swargo98/Gesture-Based-Elevator-Control-System/README.md

# Gesture Based Elevator Control System
 
For our CSE316 term project, we have built a system where we can use an elevator to go to a certain floor of a building, only by our hand gestures. This will help us a lot in avoiding touching buttons in this COVID-ridded world. We used ATMEGA micro controllers and LDR-LED couples, which is very cost effective and can be easily implement the system even in the suburban cities.

Team:
- 1705039 - Tahmeed Tarek
- 1705051 - Rasman Mubtasim Swargo
- 1705053 - Tousif Tanjim Anan
- 1705059 - Shahriar-Al-Mohaiminul (Tanmoy)

Supervisor:
Dr. A. B. M. Alim Al Islam

Youtube link of project demonstration: https://www.youtube.com/watch?v=Lgz6mq2jmfk
