swargo98/Gesture-Based-Elevator-Control-System/Circuit Diagram.PDF

## LCD

## LDR1

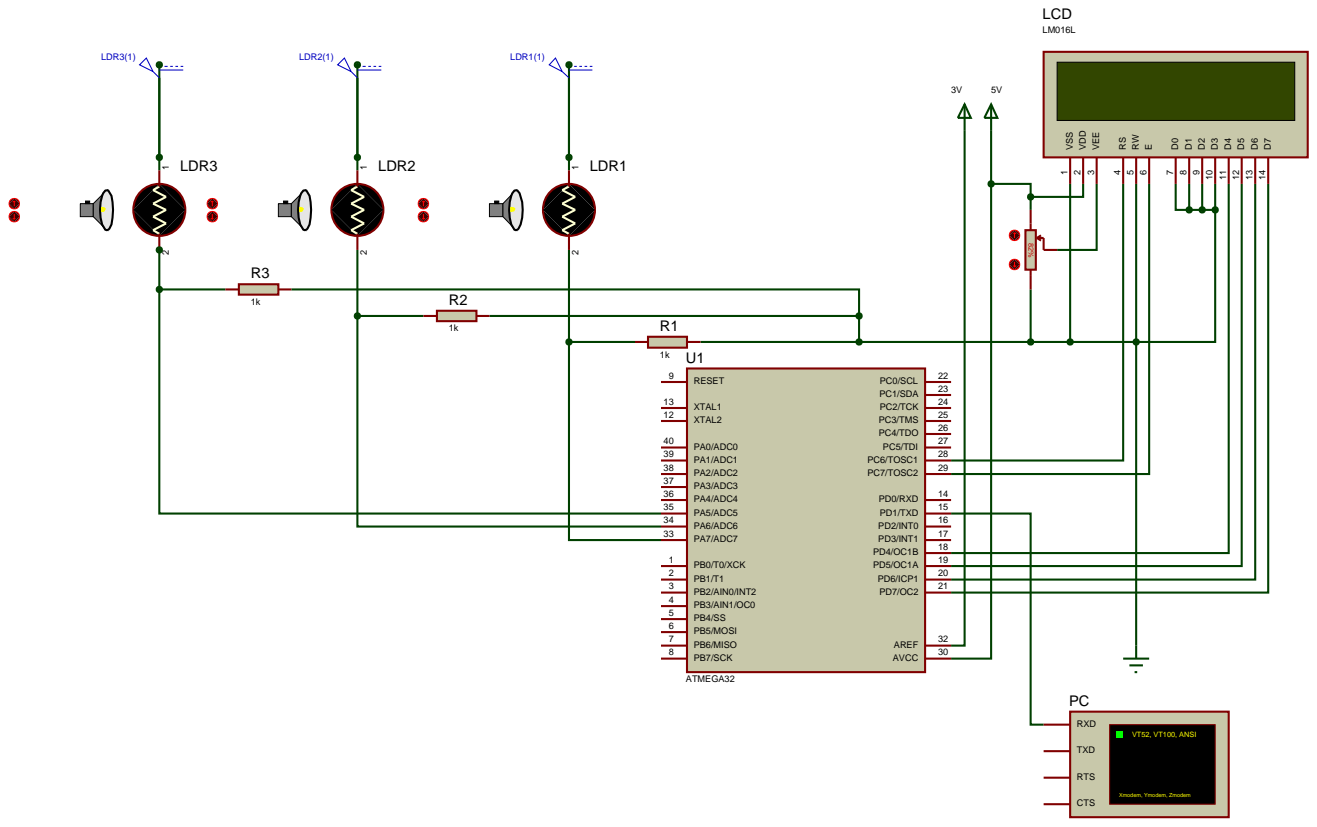
[picture p7: page 1]
