swargo98/Gesture-Based-Elevator-Control-System/(list of files, drawings)

Other design files:
GBECS_Circuit/circuit.pdsprj
