swargo98/Gesture-Based-Elevator-Control-System/GBECS_Code/Gesture/Gesture/main.c

#define F_CPU 1000000
#define D4 eS_PORTD4
#define D5 eS_PORTD5
#define D6 eS_PORTD6
#define D7 eS_PORTD7
#define RS eS_PORTC6
#define EN eS_PORTC7

#include <avr/io.h>
#include <avr/interrupt.h>
#include <stdlib.h>
#include <util/delay.h>
#include "lcd.h"

volatile int overflowCount;
volatile int timeElapsed = 0;

ISR(TIMER1_OVF_vect) {
	overflowCount++;
	if (overflowCount >= 16) {
		timeElapsed += 1;
		overflowCount = 0;
	}
}

void USART_init(void) {
	UCSRA = 0b00000010; // double speed (/8)
	UCSRB = 0b00001000; // only tx
	UCSRC = 0b10000110; // async, no parity, 1 stop, 8 data
	
	UBRRH = 0;
	UBRRL = 12; // baud rate 9600 bps
}

void UART_send(unsigned char data) {
	while ((UCSRA & (1 << UDRE)) == 0x00);
	UDR = data;
}

void USART_putstring(char* StringPtr){
	while(*StringPtr != 0x00){
		UART_send(*StringPtr);
	StringPtr++;}	
}

double read_adc()
{
	int v_adch=0, v_adcl=0, temp;
	double step_size = 0.0048828125, value;
	
	v_adcl = (int) ADCL;
	v_adch = (int) ADCH;
	
	PORTB = ADCH;
	
	value = v_adch*4 + v_adcl/64;
	value = value*step_size;
	
	temp = (int)(value * 100 + .5);
	value = (double) temp/100;
	
	return value;
}

char final_str[]="\n\r\nGoing to floor: ";
char reset_str[]="\n\r\nResetting GBECS";

int main(void)
{
	float voltage;
	int i,j;
	int fingerInSight[3];
	int inSightSum=0;
	int totalFingers = 0;
	timeElapsed = 0;
	overflowCount = 0;
	char numberArr[5];
	int digits[3];
	for(i=0; i<3; i++) {
		digits[i] = 0;
		fingerInSight[i] = 1; // prevent initial 1
	}
	
	// configure I/O
	DDRB = 0xFF;
	DDRD = 0xFF;
	DDRC = 0xFF;
	
	// configure ADC
	ADMUX = 0b01100111; // 3.0, Right, ADC7
	ADCSRA = 0b10000110; // 64

	// configure timer
	TCCR1A = 0b00000000; // normal mode
	TCCR1B = 0b00000001; // no prescaler
	TIMSK = 0b00000100; // timer 1
	sei();
	
	// set comm
	Lcd4_Init(); // LCD
	USART_init(); // USB
	
	while(1)
	{
		ADMUX = 0b01100111;	// set ADC7 as input
		for (j=0; j<3; j++)
		{
			// ================ ADC - read voltage ================
			ADCSRA |= (1 << ADSC);
			while (ADCSRA & (1 << ADSC)) {;}
			voltage = read_adc();
			ADMUX -= 1; // change input, ADC7 > ADC6 > ADC5
			
			// ================ Gesture - finger detection ================
			
			if (!fingerInSight[j] && voltage > 3) {
				// light to dark, finger
				digits[j] += 1;
				digits[j] %= 10;
				
				timeElapsed = 0;
				fingerInSight[j] = 1;
			}
			else if (fingerInSight[j] && voltage < 3) {
				// dark to light, no finger
				timeElapsed = 0;
				fingerInSight[j] = 0;
			}
			
		}
		
		// ================ Control - reset, change digit, final result ================
		
		inSightSum = 0; // to detect if finger present
		for(i=0; i<3; i++) 
			inSightSum += fingerInSight[i]; // sum=0: no, sum>0: yes
		
		if (timeElapsed > 6 && !inSightSum) {
			//USART_putstring(reset_str);
			// reset input
			timeElapsed = 0;
			for(i=0; i<3; i++) {
				digits[i] = 0;
				fingerInSight[i] = 1; // prevent initial 1
			}
		}
		else if (timeElapsed > 6 && inSightSum) {
			// send final result to PC
			USART_putstring(final_str);
			totalFingers = (100 * digits[2]) + (10 * digits[1]) +  digits[0];
			itoa(totalFingers, numberArr, 10);
			for (i=0; numberArr[i] != '\0'; i++)
				UART_send(numberArr[i]);
			
			// reset input
			timeElapsed = 0;
			for(i=0; i<3; i++) {
				digits[i] = 0;
				fingerInSight[i] = 1; // prevent initial 1
			}
		}
		
		// ================ Output - printing to LCD ================
		
		Lcd4_Set_Cursor(1, 0); // line 1
		Lcd4_Write_String("|  Floor: ");
		itoa(digits[2], numberArr, 10);
		Lcd4_Write_String(numberArr); // X00
		itoa(digits[1], numberArr, 10);
		Lcd4_Write_String(numberArr); // 0X0
		itoa(digits[0], numberArr, 10);
		Lcd4_Write_String(numberArr); // 00X
		Lcd4_Write_String("  |");
		
		Lcd4_Set_Cursor(2, 0); // line 2
		 Lcd4_Write_String("|   Time:  ");
		 itoa(timeElapsed, numberArr, 10);
		 Lcd4_Write_String(numberArr); // timeElasped
		 Lcd4_Write_String("s  |");
		//Lcd4_Write_String("| Finger: ");
		//Lcd4_Write_String((inSightSum != 0)? "Yes  |": " No  |"); // fingerInSight
	}
}
