swargo98/Gesture-Based-Elevator-Control-System/(commit log)

2021-06-26 last work
    [circuit.pdsprj]
2021-07-14 almost final
    [circuit.pdsprj]
2021-07-18 Display - finger/time, blank space
2021-07-29 Final Update
    [circuit.pdsprj]
2021-07-30 Report and Circuit
